perriestudios/Piddy-Bot/PIDDYBOT_V1_32U4.brd

## EAGLE design PIDDYBOT_V1_32U4.brd (2020-11-17)

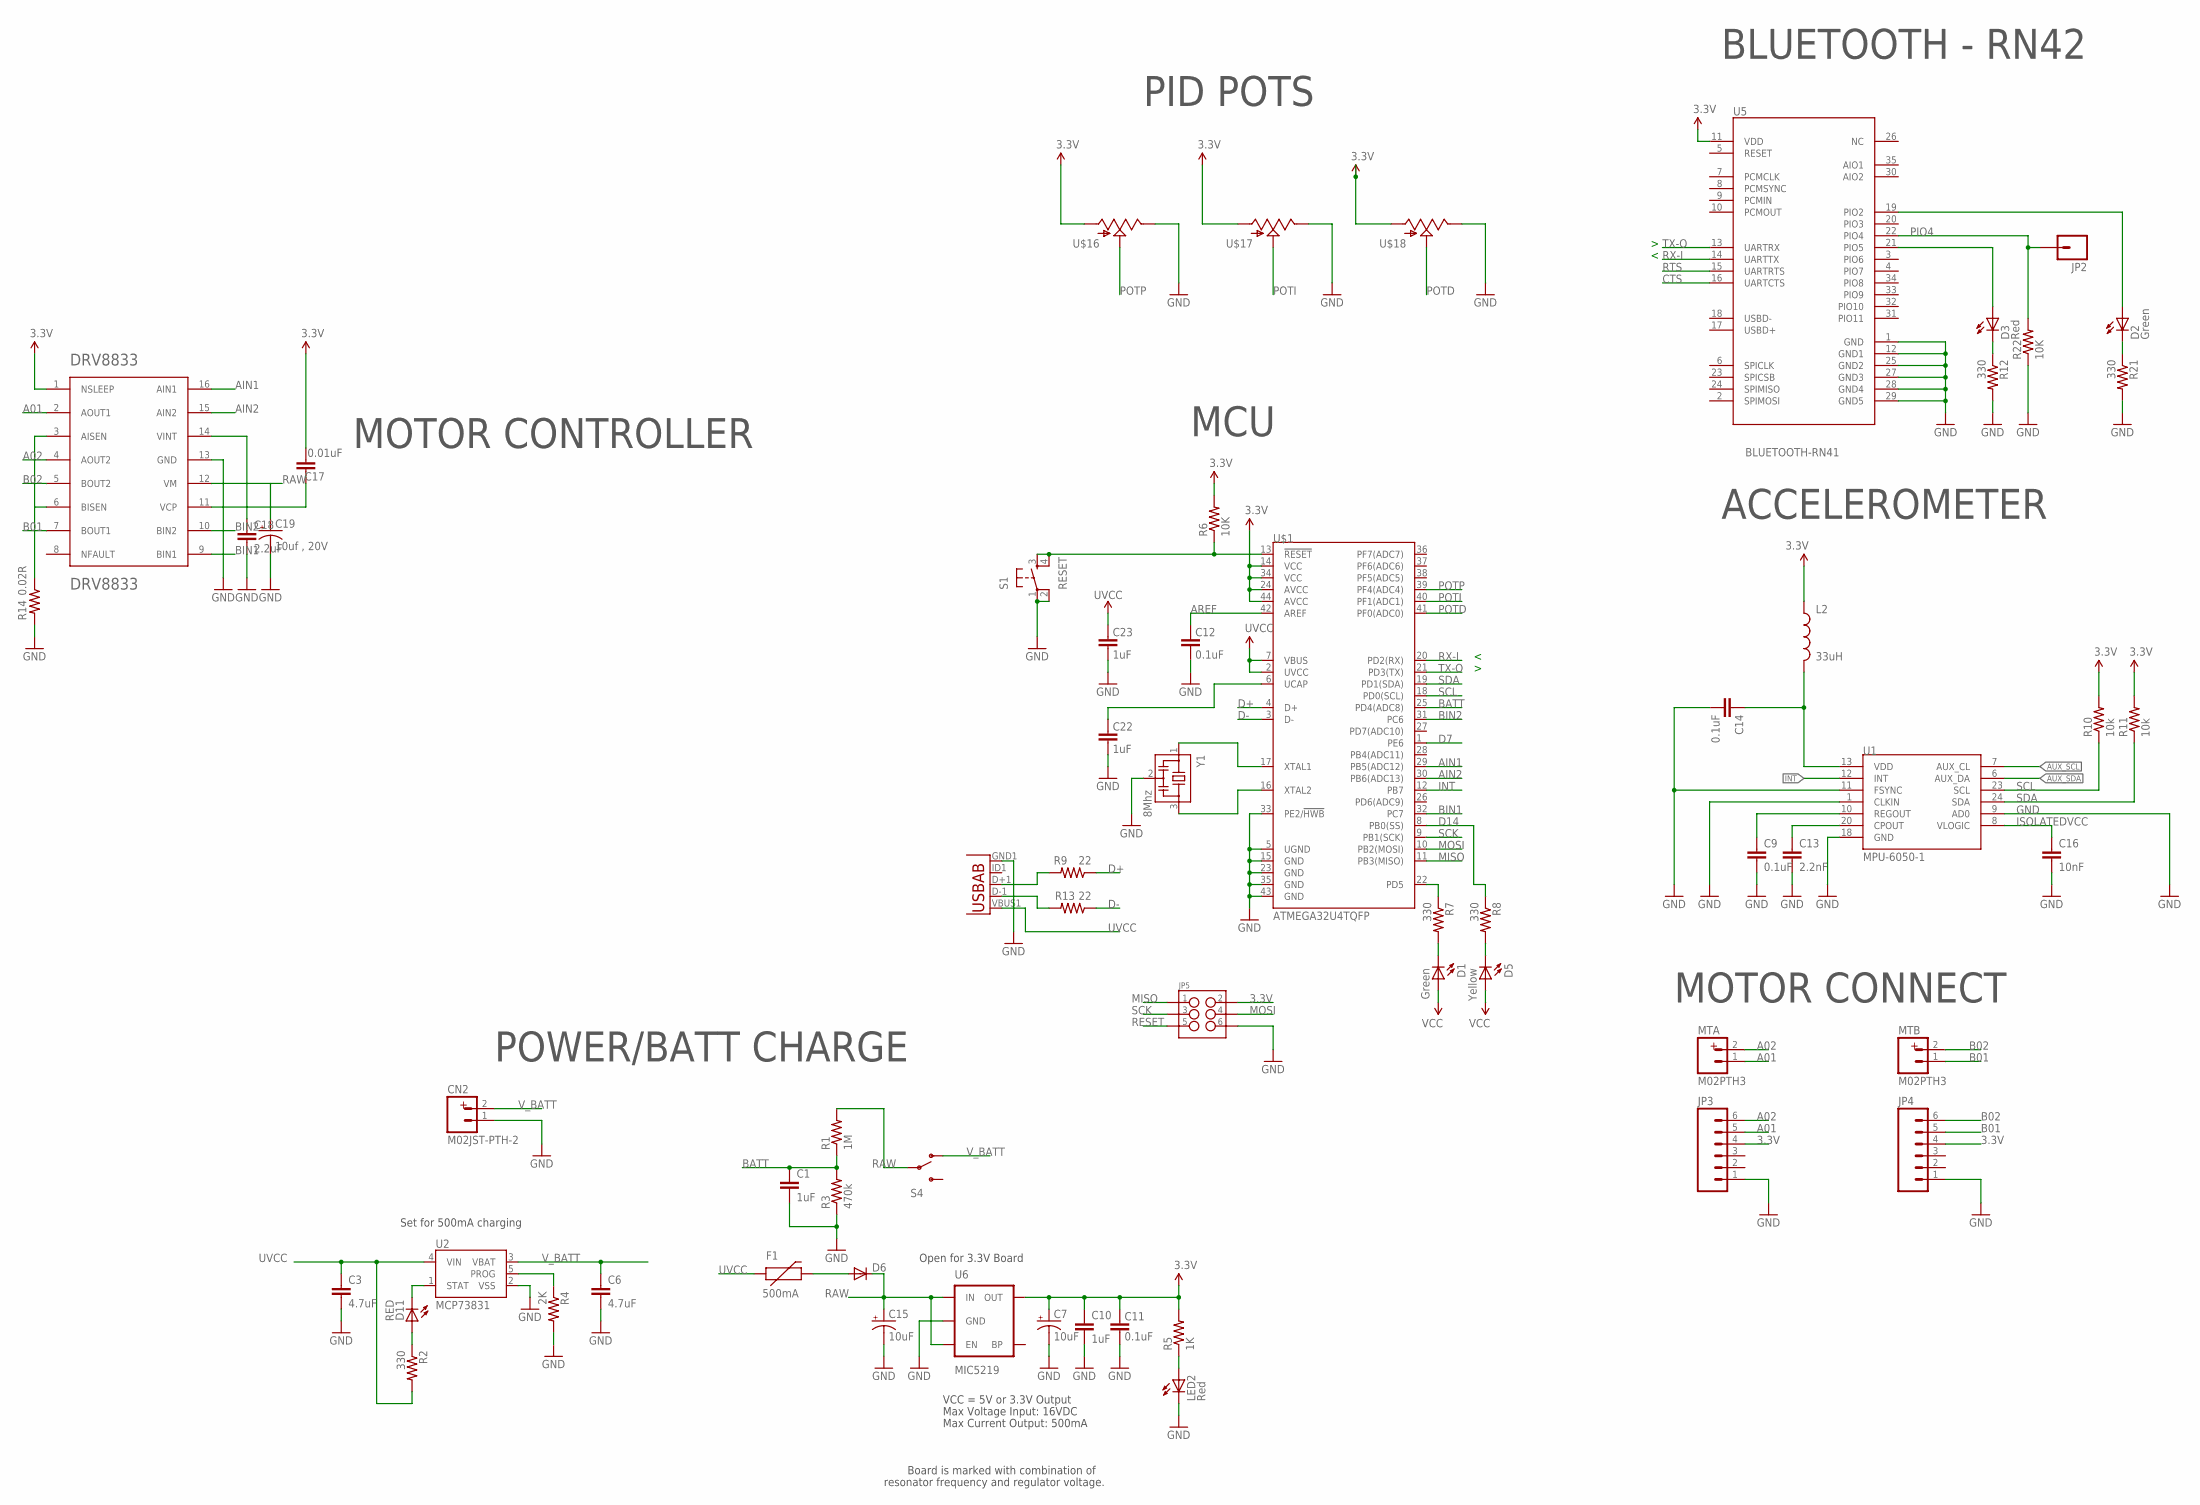
[picture p1: schematic PIDDYBOT_V1_32U4.sch]

Parts:
C1, C10, C22, C23: 1uF; 0603-CAP
C3, C6: 4.7uF; 0603-CAP
C7, C15: 10uF; EIA3216
C9, C11, C12, C14: 0.1uF; 0603-CAP
C13: 2.2nF; 0603-CAP
C16: 10nF; 0603-CAP
C17: 0.01uF; 0603-CAP
C18: 2.2uF; 0603-CAP
C19: 10uf , 20V; EIA3528
CN2: M02JST-PTH-2; JST-2-PTH
D1, D2: Green; LED-0603
D3: Red; LED-0603
D5: Yellow; LED-0603
D6: DIODESOD; SOD-323
D11: RED; LED-0603
DRV8833PWP1: DRV8833; SOP65P640X120-17N
F1: 500mA; PTC-1206
JP2: M01SMDNS; 1X01NS
JP3, JP4: M06SMD-1MM; 1X06-1MM
JP5: M03X2NO_SILK; 2X3-NS
L2: 33uH; C0402
LED2: Red; LED-0603
MTA: M02PTH3; 1X02_LONGPADS
MTB: M02PTH3; 1X02_LONGPADS
R1: 1M; 0603-RES
R2, R7, R8, R12, R21: 330; 0603-RES
R3: 470k; 0603-RES
R4: 2K; 0603-RES
R5: 1K; 0603-RES
R6, R22: 10K; 0603-RES
R9, R13: 22; 0603-RES
R10, R11: 10k; 0603-RES
R14: 0.02R; 0603-RES
S1: RESET; TACTILE_SWITCH_SMD
S4: SWITCH-SPDTPTH; SWITCH-SPDT
U1: MPU-6050-1; QFN-24-4MM2
U2: MCP73831; SOT23-5
U5: BLUETOOTH-RN41; RN41
U6: MIC5219; SOT23-5
U$1: ATMEGA32U4TQFP; SPARKFUN-DIGITALIC_TQFP44
U$16, U$17, U$18: POT; ALPS_POT
X2: USB-ABIN&OUT; USB-AB-MICRO-SMD-V03-IN&OUT
Y1: 8Mhz; CSTCR6M

Connections:
3.3V: C7.A (+), C10.1, C11.2, C17.2, D1.A, D5.A, DRV8833PWP1.1 (NSLEEP), JP3.4, JP4.4, JP5.2, L2.1, R5.2, R6.2, R10.2, R11.2, U5.11 (VDD), U6.5 (OUT), U$1.14 (VCC), U$1.24 (AVCC), U$1.34 (VCC), U$1.44 (AVCC), U$16.P$3 (A), U$17.P$3 (A), U$18.P$3 (A)
A01: DRV8833PWP1.2 (AOUT1), JP3.5, MTA.1
A02: DRV8833PWP1.4 (AOUT2), JP3.6, MTA.2
AIN1: DRV8833PWP1.16 (AIN1), U$1.29 (PB5(ADC12))
AIN2: DRV8833PWP1.15 (AIN2), U$1.30 (PB6(ADC13))
AREF: C12.2, U$1.42 (AREF)
AUX_SCL: U1.7 (AUX_CL)
AUX_SDA: U1.6 (AUX_DA)
B01: DRV8833PWP1.7 (BOUT1), JP4.5, MTB.1
B02: DRV8833PWP1.5 (BOUT2), JP4.6, MTB.2
BATT: C1.1, R1.1, R3.2, U$1.25 (PD4(ADC8))
BIN1: DRV8833PWP1.9 (BIN1), U$1.32 (PC7)
BIN2: DRV8833PWP1.10 (BIN2), U$1.31 (PC6)
CTS: U5.16 (UARTCTS)
D1: D3.C, R12.1
D2: D2.C, R21.1
D7: U$1.1 (PE6)
D14: R8.1, U$1.8 (PB0(SS))
D+: R9.1, U$1.4 (D+)
D-: R13.1, U$1.3 (D-)
GND: C1.2, C3.2, C6.2, C7.C (-), C9.2, C10.2, C11.1, C12.1, C13.2, C14.2, C15.C (-), C16.2, C18.2, C19.C (-), C22.1, C23.1, CN2.1, DRV8833PWP1.13 (GND), JP3.1, JP4.1, JP5.6, LED2.C, R3.1, R4.2, R12.2, R14.2, R21.2, R22.1, S1.1, S1.2, U1.1 (CLKIN), U1.9 (AD0), U1.11 (FSYNC), U1.18 (GND), U2.2 (VSS), U5.1 (GND), U5.12 (GND1), U5.25 (GND2), U5.27 (GND3), U5.28 (GND4), U5.29 (GND5), U6.2 (GND), U$1.5 (UGND), U$1.15 (GND), U$1.23 (GND), U$1.33 (PE2/!HWB), U$1.35 (GND), U$1.43 (GND), U$16.P$1 (E), U$17.P$1 (E), U$18.P$1 (E), X2.GND1 (GND), Y1.2
INT: U1.12 (INT), U$1.12 (PB7)
ISOLATEDVCC: C14.1, C16.1, L2.2, U1.8 (VLOGIC), U1.13 (VDD)
MISO: JP5.1, U$1.11 (PB3(MISO))
MOSI: JP5.4, U$1.10 (PB2(MOSI))
unnamed: U$1.17 (XTAL1), Y1.1
unnamed: U$1.16 (XTAL2), Y1.3
unnamed: D6.2 (A), F1.2
unnamed: C13.1, U1.20 (CPOUT)
unnamed: C9.1, U1.10 (REGOUT)
unnamed: D3.A, U5.21 (PIO5)
unnamed: D2.A, U5.19 (PIO2)
unnamed: D11.A, R2.1
unnamed: C22.2, U$1.6 (UCAP)
unnamed: R13.2, X2.D-1 (D-)
unnamed: R9.2, X2.D+1 (D+)
unnamed: C17.1, DRV8833PWP1.11 (VCP)
unnamed: D5.C, R8.2
unnamed: D1.C, R7.2
unnamed: DRV8833PWP1.3 (AISEN), DRV8833PWP1.6 (BISEN), R14.1
unnamed: C18.1, DRV8833PWP1.14 (VINT)
unnamed: LED2.A, R5.1
PIO4: JP2.1, R22.2, U5.22 (PIO4)
POTD: U$1.41 (PF0(ADC0)), U$18.P$2 (S)
POTI: U$1.40 (PF1(ADC1)), U$17.P$2 (S)
POTP: U$1.39 (PF4(ADC4)), U$16.P$2 (S)
PROG: R4.1, U2.5 (PROG)
RAW: C15.A (+), C19.A (+), D6.1 (C), DRV8833PWP1.12 (VM), R1.2, S4.2, U6.1 (IN), U6.3 (EN)
RESET: JP5.5, R6.1, S1.3, S1.4, U$1.13 (!RESET)
RTS: U5.15 (UARTRTS)
RX-I: U5.14 (UARTTX), U$1.20 (PD2(RX))
SCK: JP5.3, U$1.9 (PB1(SCK))
SCL: R10.1, U1.23 (SCL), U$1.18 (PD0(SCL))
SDA: R11.1, U1.24 (SDA), U$1.19 (PD1(SDA))
STAT: D11.C, U2.1 (STAT)
TX-O: U5.13 (UARTRX), U$1.21 (PD3(TX))
TXLED: R7.1, U$1.22 (PD5)
UVCC: C3.1, C23.2, F1.1, R2.2, U2.4 (VIN), U$1.2 (UVCC), U$1.7 (VBUS), X2.VBUS1 (VBUS)
V_BATT: C6.1, CN2.2, S4.1 (O), U2.3 (VBAT)

Notes on the sheet:
Set for 500mA charging
Max Voltage Input: 16VDC
Max Current Output: 500mA
Board is marked with combination of
resonator frequency and regulator voltage.
VCC = 5V or 3.3V Output
Open for 3.3V Board
MOTOR CONTROLLER
MCU
PID POTS
BLUETOOTH - RN42
ACCELEROMETER
MOTOR CONNECT
POWER/BATT CHARGE

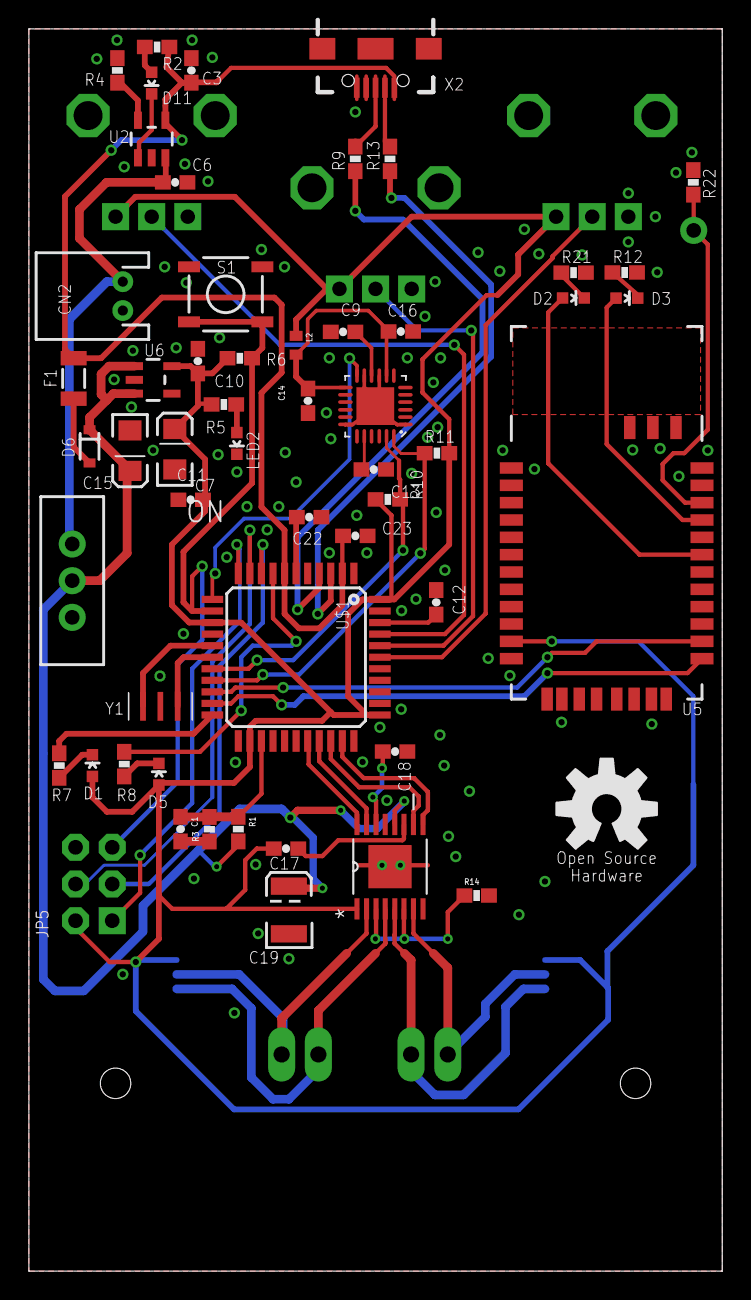
[picture p2: board PIDDYBOT_V1_32U4.brd from above]

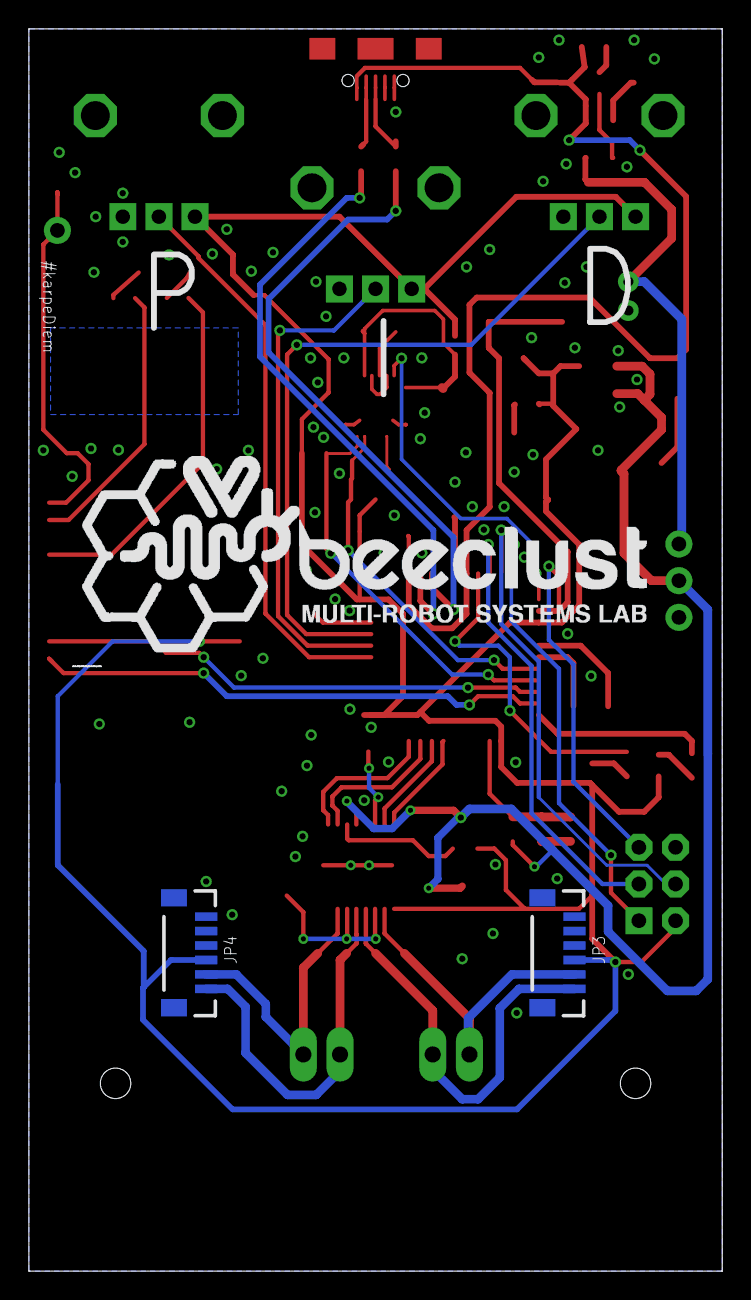
[picture p3: board PIDDYBOT_V1_32U4.brd from below]

Board: 2 copper layers, 48.0 x 86.0 mm, 64 parts (6 on the bottom side), 54 nets.

Other parts of the board:
U$2: LOGO-L
U$3: OSHW-LOGO-L
